bkiu/termdeck/printables/Cyberdeck Front.stl

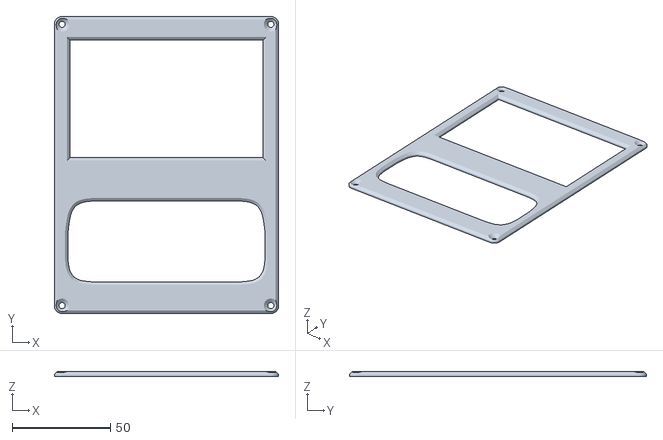
[picture p1: CAD file, 2026-11-10]
printables/Cyberdeck Front.stl
114.0 x 150.9 x 2.60
