bkiu/termdeck/printables/Cyberdeck Back.stl

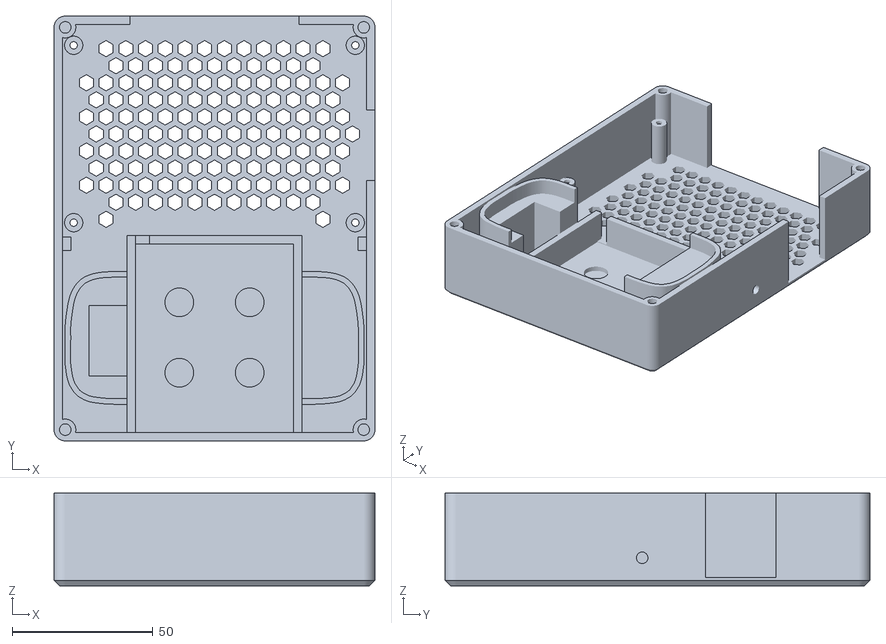
[picture p2: CAD file, 2026-11-10]
printables/Cyberdeck Back.stl
114.0 x 150.9 x 33.0
