bkiu/termdeck/printables/Battery Cover.stl

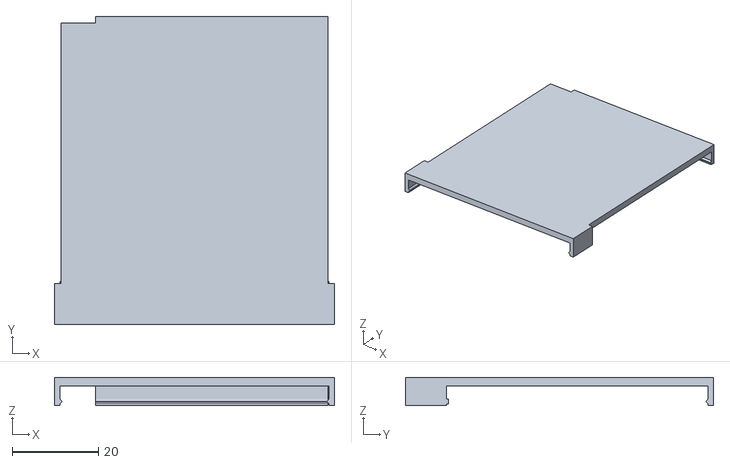
[picture p3: CAD file, 2026-11-10]
printables/Battery Cover.stl
65.0 x 71.5 x 6.50
